Long12102007/Nhom3-smart-acoustic/reports/week-07.md

# Báo cáo tuần 7 (28/09 – 04/10/2026)

**đã làm**
- huấn luyện bổ sung và nâng cao độ chính xác AI
- Hiệu chỉnh phần cứng với độ nhạy Micro
- Cải thiện và tối ưu giao diện ứng dụng
- kiểm thử thực tế
