Long12102007/Nhom3-smart-acoustic/presentation/Trợ_ý_Giám_sát_Trẻ_em_bằng_âm thanh.pptx

ĐỒ ÁN MÔN HỌC • CÔNG NGHỆ KỸ THUẬT MÁY TÍNH

Trợ lý Giám sát Trẻ em bằng âm thanh

Hệ thống thu âm thông minh kết hợp Edge AI (TinyML) trên ESP32 và ứng dụng quản lý đám mây

Giảng viên hướng dẫn

Th.S. Huỳnh Hoàng Hà

Nhóm sinh viên thực hiện

Lê Đỗ Minh Chiến | Huỳnh Ngọc Bảo Long

## Slide 2

Tổng quan & Tính cấp thiết

Giải quyết bài toán giám sát an toàn cho trẻ nhỏ trong đời sống hiện đại

Hạn chế phương pháp cũ

Camera: Nguy cơ rò rỉ riêng tư không gian sinh hoạt cá nhân.

Cảm biến ngưỡng: Dễ gây báo động giả do tạp âm sinh hoạt (tivi, quạt).

Giải pháp Edge AI đề xuất

Xử lý tại biên: Nhận diện tiếng khóc trực tiếp trên vi điều khiển ESP32.

Bảo mật tuyệt đối: Không truyền dữ liệu âm thanh thô lên không gian mạng.

## Slide 3

Kiến trúc tổng thể hệ thống

Luồng xử lý khép kín từ phần cứng nhúng đến ứng dụng di động đám mây

Thu âm INMP441

Giao tiếp I2S số 16 kHz, 16-bit, kênh trái.

Xử lý Edge AI

Spectrogram FFT kết hợp mạng CNN 1D (INT8).

Đám mây Firebase

Realtime Database đồng bộ trạng thái thời gian thực.

Ứng dụng di động

React Native hiển thị lịch sử và phát chuông cảnh báo.

## Slide 4

Thiết kế phần cứng & Firmware nhúng

Tối ưu hóa phần cứng ESP32-WROOM-32 kết hợp cảm biến INMP441

Đặc điểm kỹ thuật Firmware

Cấu hình linh hoạt: Web Server AP Mode lưu cấu hình qua EEPROM.

Chống treo CPU: Tối ưu hóa thời gian đọc I2S.

Đồng bộ thời gian: NTP đảm bảo xác thực SSL ổn định với Firebase.

Sơ đồ kết nối I2S

WS (Word Select): Chân GPIO 15

SCK (Bit Clock): Chân GPIO 14

SD (Serial Data): Chân GPIO 32

L/R: Nối mass (kênh trái)

## Slide 5

Xây dựng mô hình Edge AI (Edge Impulse)

Quy trình xử lý tín hiệu âm thanh và học máy nhúng TinyML

Dữ liệu huấn luyện

Quy mô: 864 mẫu tổng thời lượng 17 phút 07 giây.

Phân lớp: Lớp crying (32%) và lớp noise (68%).

Nguồn dữ liệu: 60% thu thực tế bằng INMP441, 40% từ nguồn công khai.

Trích xuất đặc trưng & Mạng

DSP Spectrogram: 99 khung × 65 tần số = 6.435 giá trị đầu vào.

Kiến trúc CNN 1D: Conv1D (8 filter) → Dense (256) → Softmax.

Lượng tử hóa: INT8 toàn phần qua EON Compiler.

## Slide 6

Kết quả huấn luyện AI & Hiệu năng thiết bị

Đánh giá độ chính xác mô hình và tốc độ suy luận trên vi điều khiển

93.89%

Độ chính xác trên tập kiểm thử (Test Accuracy)

79-83ms

Tổng thời gian xử lý mỗi cửa sổ 1 giây

30.2 KB

Dung lượng trọng số mô hình INT8

## Slide 7

Hậu xử lý & Thực nghiệm phần cứng

Bộ lọc quyết định Hysteresis và khả năng chống báo giả

Kết quả thực nghiệm

Hệ số khuếch đại: Chọn `MIC_GAIN = 6.0` tối ưu dải động tín hiệu.

Khả năng nhận diện: Nhạy bén với tiếng khóc trong môi trường có tạp âm.

Báo giả: Không ghi nhận báo động giả trong các mẫu kiểm thử thuần tạp âm.

Bộ lọc Hysteresis

Ngưỡng vào: Điểm crying ≥ 0,80 chuyển sang trạng thái ĐANG KHÓC.

Ngưỡng ra: Điểm crying < 0,50 quay về trạng thái YÊN BÌNH.

Hiệu quả: Ngăn chặn tình trạng nhấp nháy trạng thái và tránh ghi trùng lịch sử.

## Slide 8

Phần mềm ứng dụng di động (React Native)

Xây dựng ứng dụng đa nền tảng bằng React Native kết hợp Expo Router

Định tuyến Expo Router

Cấu trúc file-based routing hiện đại, quản lý tab và ngăn xếp màn hình tối ưu.

Giám sát Realtime

Lắng nghe sự thay đổi trạng thái bé và lịch sử cảnh báo trực tiếp từ Firebase.

Phát âm thanh cảnh báo

Sử dụng thư viện `react-native-sound` quản lý và phát nhạc chuông tùy chỉnh.

## Slide 9

Kiểm thử ứng dụng & Đánh giá hiệu năng

Kết quả đo đạc độ trễ đồng bộ và độ ổn định thực tế trên thiết bị Android

Độ ổn định hệ thống

Tương thích: Hoạt động mượt mà trên thiết bị Android từ phiên bản 14.

Kiểm thử chức năng: Đạt yêu cầu đăng nhập, xem lịch sử và tùy chỉnh nhạc chuông.

Hạn chế ghi nhận: Cảnh báo hiện tại phụ thuộc vào ứng dụng đang mở (foreground).

Độ trễ đồng bộ (Trung bình)

T1 (ESP32 phát hiện): ~1,42 giây

T2 (Firebase đẩy về App): ~0,72 giây

Tổng độ trễ phản hồi: ~2,14 giây

## Slide 10

TỔNG KẾT ĐỒ ÁN

Kết luận & Hướng phát triển

Kết quả đạt được

• Hoàn thiện toàn diện hệ thống phần cứng Edge AI và ứng dụng di động.

• Mô hình TinyML chạy mượt mà, bảo mật riêng tư tuyệt đối cho gia đình.

Hướng phát triển

• Tích hợp Firebase Cloud Messaging (FCM) thông báo đẩy nền.

• Mở rộng tập dữ liệu huấn luyện và nâng cấp bảo mật phân quyền thiết bị.
