Long12102007/Nhom3-smart-acoustic/(commit log)

2026-09-28 report tuần 7
2026-10-27 bổ sung thông tin cuối cùng
    [Bang_phan_nv.xlsx, Bang_tien_do.xlsx]
2026-10-27 bổ sung AI với hardware
